meekm/LoRaSoundkit/images/ics43434.png

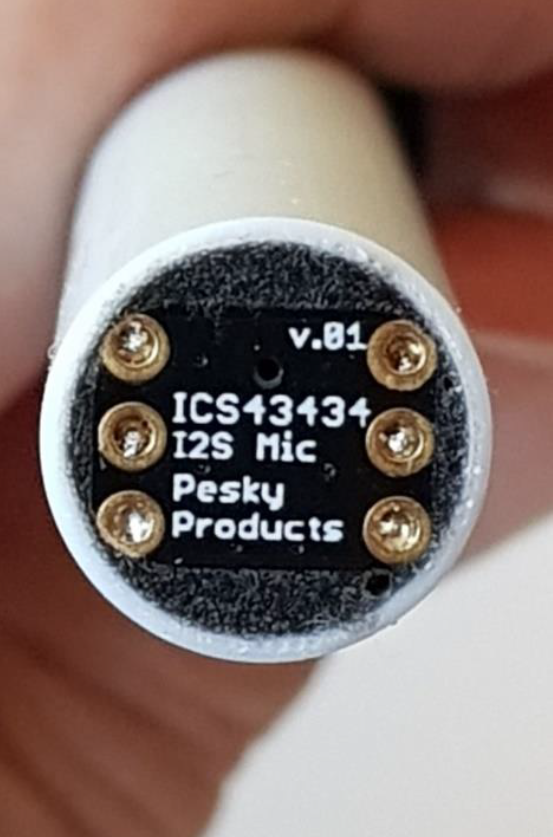
images/ics43434.png
