meekm/LoRaSoundkit/images/soundkit.jpg

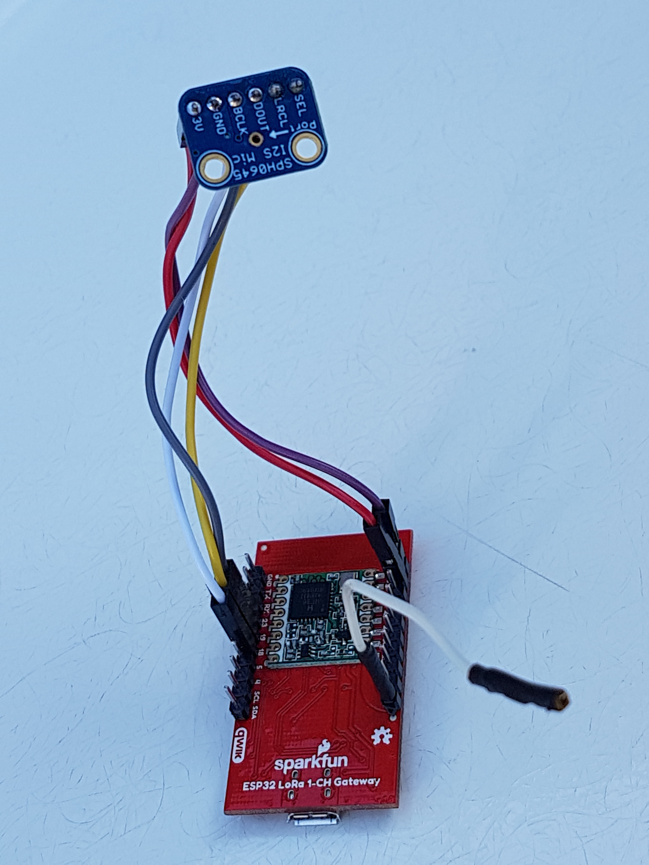
images/soundkit.jpg
