meekm/LoRaSoundkit/images/ttgo-oled.jpg

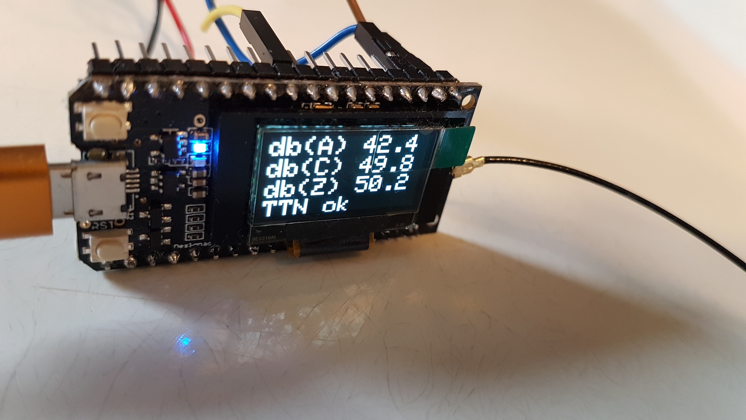
images/ttgo-oled.jpg
