meekm/LoRaSoundkit/(threads)

Thread 4 (2021-10-30):

wrong values

theArcher73, 2021-10-30:
Hi,

I have trouble with the measurements. When I start the sensor I get correct values.
After 2-3 measurments the display switch to a scarry pricture.
Also over LoRa I get from this moment static values for each data-transmission.

so I have the following pic:

|        |avg |min | max
|-----|-----|-----|-----|
|       |     |     |     |
| 4B(C)|-inf |-inf | -379.|
| 2B(Z)|-inf |-inf | -379.|
| 3   |     |     |     |
|TTN  |ok   |     |     |

After a reboot thesame effect.

Do you know this effects?

Thx,
Steffen

meekm, 2021-10-30:
Hi,
These values I recognize, when I made a mistake in wiring the MEMS.  In your situation in the begin the values are correct, so I Think it is not the wiring, but maybe a weak power supply.
Try to comment out the loraSend (2 places in the .ino file).  The loraSend takes some power.

theArcher73, 2021-10-31:
Typical Problem between chair and solder iron. GPIO35 should be used, not GPIO39 🙈

I found the mistake while shortening all wires. It works, thx and sorry.

Now I will wait that TTN ok appears, what's are the reasons for the message TTN fail, while I can see the right values in the TTN-Server?

Steffen

meekm, 2021-10-31:
I checked the code, the TTN fail/Ok  is one cycle behind. This can be improved in the next version.

Closed 2021-10-31.

Thread 6 (2022-01-15):

Frequency calculations

rdkluijv, 2022-01-15:
I'm lost when I look at the frequency calculation.
First:
With 2048 samples multiple by 11 is 22528. Why use 22628?
Second:
With 22628 the maximum frequency that can be detected is 22628 / 2 = 11314 Hz. (Shannon)
With a 2048 length vector from the FFT I would expect a resolution of 5,5 Hz.
What's wrong with my calculation?

meekm, 2022-01-16:
Answer 1:
The reason why this sample frequency has been chosen, is to map the bins nicely around the center frequency of the octaves. Thus measuring the energy of octave 31,25 Hz is the sum of exactly bin 1 and bin 2, which is the frequency range 22Hz to 44Hz. The measuring of octave 62,5 Hz is the sum of the energy in bin 3 up to 6, which is the frequency range 44Hz to 88Hz etc ...

Answer 2
Correct, te highest frequency is sample frequency /2

Answer 3
The resolution is the bin size, which is sample frequency devided by buffersize, which is 22628/2048 is 11 Hz

Closed 2022-01-16.

Thread 7 (2022-01-15):

Mems sleep mode

rdkluijv, 2022-01-15:
All the microphones go in to sleep mode after not receiving a clock. When they start getting a clock it takes a while for the samples to be valid. I can't find the code where those samples are removed. Is that not necessary?

meekm, 2022-01-16:
According me, the microphone goes never into sleep. The sensor is measuring continuously.
Do you think, the code is not complete, and samples must be removed?
There are no hicks in the sound when sending the samples to a wave file, and listen to it.

Closed 2022-01-16.

Thread 8 (2022-01-15):

Arduino FFT versus ESP DSP

rdkluijv, 2022-01-15:
There is a digital processing library for the ESP32. That library is optimized for the ESP32. I'm curious why the generic Arduino library is used. Has that benefits?

meekm, 2022-01-16:
I am not aware of a digital processing library for the ESP 32. May be it is a better choice for future releases an i will take it into account.
Thanks for your remarks.

Closed 2022-01-16.
