meekm/LoRaSoundkit/src/measurement.h

/*--------------------------------------------------------------------
  This file is part of the TTN-Apeldoorn Sound Sensor.

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
  The program is distributed in the hope that it will be useful,
  but WITHOUT ANY WARRANTY; without even the implied warranty of
  MERCHANTABILITY or FITNESS FOR A PARTICULAR PURPOSE.
  --------------------------------------------------------------------*/

/*!
 * \file measurement.h
 * \brief measurement class for TTN-Apeldoorn Sound Sensor.
 * Converts energy spectrum to a weighted DB level.
 * \author Marcel Meek
 * \date See revision table
 * \version see revision table
 * 
 * ## version
 * 
 * version | date       | who            | Comment
 * --------|------------|----------------|-------------------------------------
 * 0.1     | 22-4-2020  | Marcel Meek    | Initial release within community for
 *         |            |                | review and testing within dev-team
 * 0.2     | 24-4-2020  | Remko Welling  | Added headers, Sanitize code, add 
 *         |            |                | Doxygen compatible comments, add 
 *         |            |                | include guards
 *         |            |                |
 *
 * # References
 *
 * This code is inspired on code of third parties:
 * - example: https://bitbucket.org/edboel/edboel/src/master/noise/
 * 
 * # Dependencies
 * 
 * 
 * # ToDo
 * \todo RW Add documentation on hardware connections
 */

#ifndef __MEASUREMENT_H_
#define __MEASUREMENT_H_

#define OCTAVES 9

// A, C and Z weighting curves from in steps of whole octaves
// spectrum           31,5Hz  63Hz  125Hz 250Hz  500Hz 1kHz 2kHz 4kHz 8kHz 
#define A_WEIGHTING { -39.4, -26.2, -16.1, -8.6, -3.2, 0.0, 1.2, 1.0, -1.1 };
#define C_WEIGHTING {  -3.0,  -0.8,  -0.2,  0.0,  0.0, 0.0, 0.2, 0.3, -3.0 };
#define Z_WEIGHTING {   0.0,  -0.0,  -0.0,  0.0,  0.0, 0.0, 0.0, 0.0,  0.0 };


class Measurement {
  public:
    /// \brief constructor
    /// \param [in] weighting Weighting factor for class
    Measurement( float* weighting);
    
    /// \brief Reset
    void reset();
    
    /// \brief Update energies?
    /// \param [in] energies ?
    void update( float* energies);
    
    /// \param calculate result
    void calculate();
    
    /// \brief calculate dB value for power
    /// \param [in] v Value in power to be converted in to dB.
    /// \return [out] value v in dB.
    float decibel(float v);
    
    /// \brief Print debug information.
    void print();

   // public members
    float spectrum[OCTAVES];  ///< Array of results in dB per frequency band.
    float avg, min, max;      ///< avg, min and max result value in dB.
    int n;
 
  private:
    float _spectrum[OCTAVES];  ///< working array in energy per frequency band.
    float _avg, _min, _max;   ///< working avg, min , max based in energy.
    float* _weighting;        ///< Weighting factors
    int    _n;                ///< number of measurements
}; 

#endif //__MEASUREMENT_H_
