meekm/LoRaSoundkit/src/measurement.cpp

/*--------------------------------------------------------------------
  This file is part of the TTN-Apeldoorn Sound Sensor.

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
  The program is distributed in the hope that it will be useful,
  but WITHOUT ANY WARRANTY; without even the implied warranty of
  MERCHANTABILITY or FITNESS FOR A PARTICULAR PURPOSE.
  --------------------------------------------------------------------*/

/*!
   \file measurement.cpp
   \author Marcel Meek
   \date See revision table in header file
   \version see revision table in header file

   # ToDo
   \todo RW Add documentation on hardware connections
*/
#include <float.h>
#include <Arduino.h>
#include "measurement.h"

Measurement::Measurement( float* weighting) {
  _weighting = weighting;
  for ( int i = 0; i < OCTAVES; i++)
    _weighting[i] = pow(10, _weighting[i] / 10.0);  // convert dB constants to energy level constants
  reset();
}

void Measurement::reset() {
  _avg = 0.0;
  _n = 0;
  _min = FLT_MAX;
  _max = FLT_MIN;

  for ( int i = 0; i < OCTAVES; i++)
    _spectrum[i] = 0.0;
}

void Measurement::update( float* energies ) {
  _n++;
  float sum = 0.0;                             // sum in energy for this measurement
  for (int i = 0; i < OCTAVES; i++) {
    float v = energies[i] * _weighting[i];
    _spectrum[i] += v;                          // sum energy per band for all measurements
    sum += v;
  }
  _avg += sum;

  if ( _max < sum) _max = sum;
  if ( _min > sum) _min = sum;
}

void Measurement::calculate() {
  avg = decibel( _avg / (float)_n);           // calculate average and convert to dB
  min = decibel( _min);                       // convert to dB
  max = decibel( _max); 
  n = _n;                      // convert to dB

  // calculate average for each band and convert to dB
  for ( int i = 0; i < OCTAVES; i++) {
    float val = _spectrum[i] / (float)_n;     // energy average
    spectrum[i] = decibel( val);              // convert to dB
  }
  reset();
}

float Measurement::decibel(float v) {
  return 10.0 * log10(v);                    // for energy this should be 20.0 * log...  to be checked!
}

void Measurement::print() {
  printf("count=%d min=%.1f max=%.1f avg=%.1f  =>", n, min, max, avg);
  for (int i = 0; i < OCTAVES; i++)
    printf(" %.1f", spectrum[i]);
  printf("\n");
}
