meekm/LoRaSoundkit/(commit log)

2020-06-02 Create soundsensor.h
    Device and fft initialization moved from ino file to this class
2020-06-02 Update lorasoundkit.ino
    clean up ino file, device details moved to soundsensor class
2021-03-21 Update lora.cpp
    reset busy flag after "Joined"
    [lora.cpp]
2021-05-16 Fix min/max to be the same as the average after a while
    This will prevent the minimum and maximum to be the same as the average after a while.
    Does not seem to occur when serial monitor is active
    [measurement.cpp]
2021-08-19 Major upgrade
    - Worker loop changed (hang situation solved with TTN V3)
    - OLED display added
    - DEVEUI obtained from BoardID, (same SW for multiple sensors)
    - use the TWO processor cores of ESP (one core for audio and one core for LoRa)
    - DC offset MEMS compensated by moving average window
    - payload compressed from 27 to 19 bytes
    [config.h, lora.cpp, lora.h, soundsensor.cpp, soundsensor.h]
2021-11-03 set microphone dependent correction
    [config.h]
2021-11-27 Add a timer indicator to display when the next upload to LoRa will be
    Configurable to show in config.h
2024-03-18 Update README.md
    - Sources adapted for LilyGO TTGO T3 LoRa32 board (10dB better radio performance)
    - Sources adapted for VC PlatformIO (arduino IDE support not tested)
    - During a TTN connect phase, the I2S MEMS driver is stopped, because it gives Rx radio interference
    - The update of the OLED display is moved from the sound thread to the main thread.
