meekm/LoRaSoundkit/(notices)

Notices in the files:
src/arduinoFFT.h:
This program is free software: you can redistribute it and/or modify
it under the terms of the GNU General Public License as published by
the Free Software Foundation, either version 3 of the License, or
(at your option) any later version.
src/measurement.h:
(http://creativecommons.org/licenses/by-nc/4.0/) by
TTN-Apeldoorn (https://www.thethingsnetwork.org/community/apeldoorn/)
